smalben/Moose-Track/README.md

# Moose-Track

This is a shooting helpy thing
