smalben/Moose-Track/Documentation/motor_dimensions_zpsbda341d0.jpg

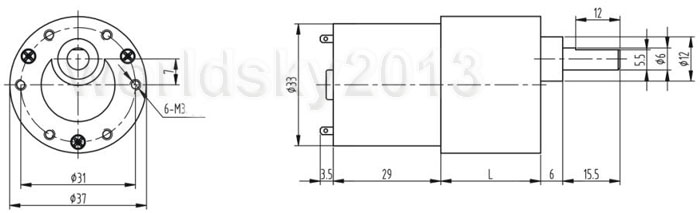
Documentation/motor_dimensions_zpsbda341d0.jpg
