smalben/Moose-Track/Documentation/proximity sensor sn04.jpg

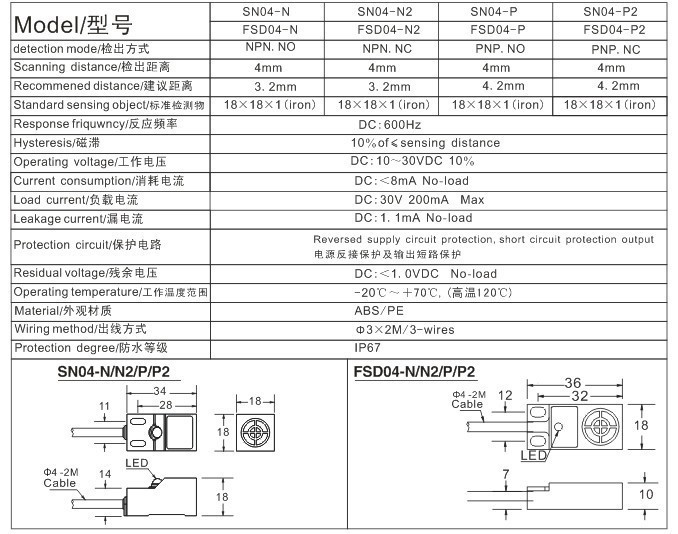
Documentation/proximity sensor sn04.jpg
