smalben/Moose-Track/CAD/drivhjul40.SLDPRT

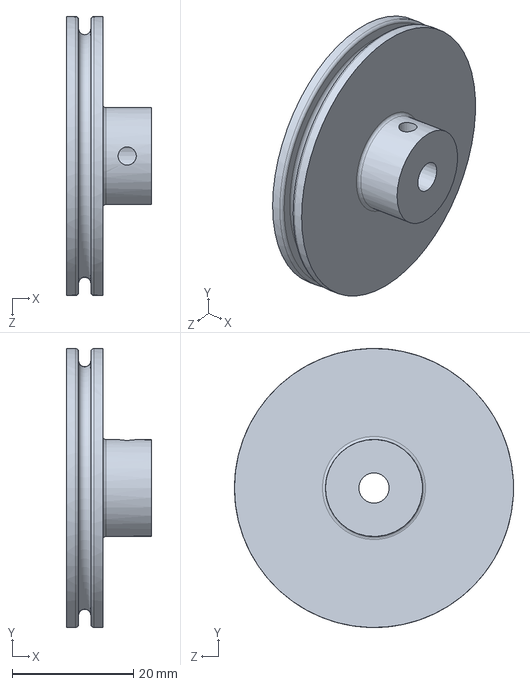
[picture p3: CAD file, 2018-02-24]
CAD/drivhjul40.SLDPRT
14.0 x 46.0 x 46.0 mm
