smalben/Moose-Track/CAD/drivhjul30_3.STL

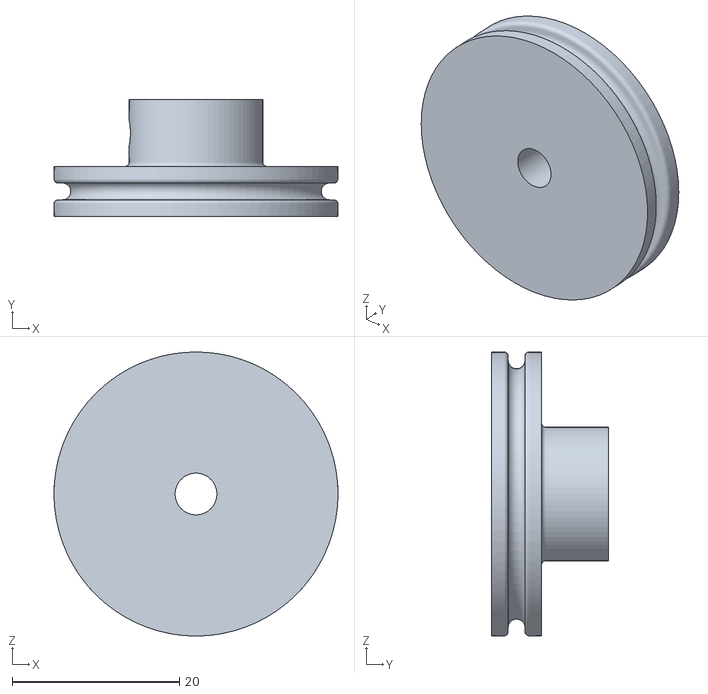
[picture p4: CAD file, 2018-02-24]
CAD/drivhjul30_3.STL
34.0 x 14.0 x 34.0
