smalben/Moose-Track/CAD/drivhjul40_3.STL

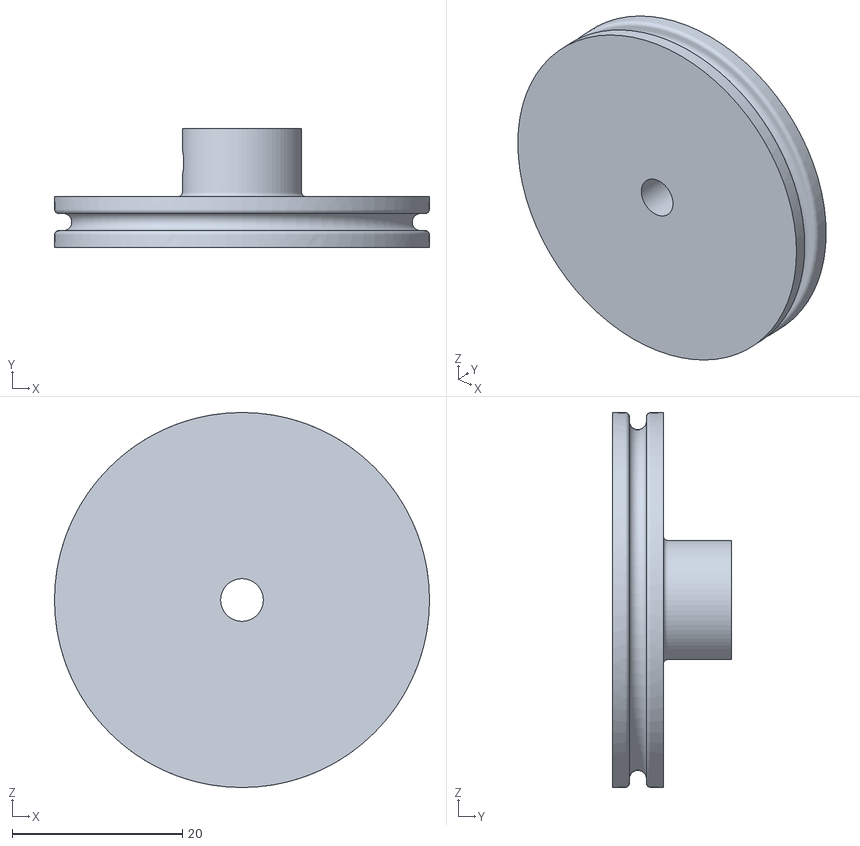
[picture p5: CAD file, 2018-02-24]
CAD/drivhjul40_3.STL
44.0 x 14.0 x 44.0
