smalben/Moose-Track/CAD/drivhjul30.SLDPRT

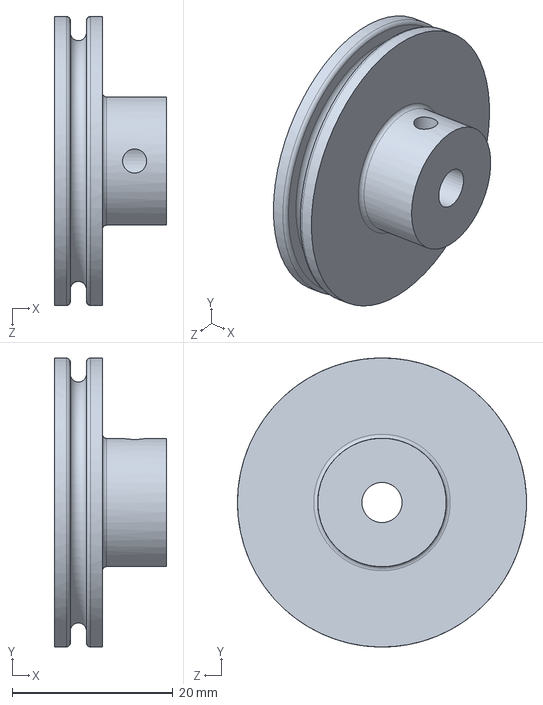
[picture p6: CAD file, 2018-02-24]
CAD/drivhjul30.SLDPRT
14.0 x 36.0 x 36.0 mm
