smalben/Moose-Track/(list of files, cad)

Other CAD files:
CAD/drivhjul40_2.STL
CAD/drivhjul30_2.STL
CAD/Drivhjul.dwg
