smalben/Moose-Track/Documentation/öra.pdf

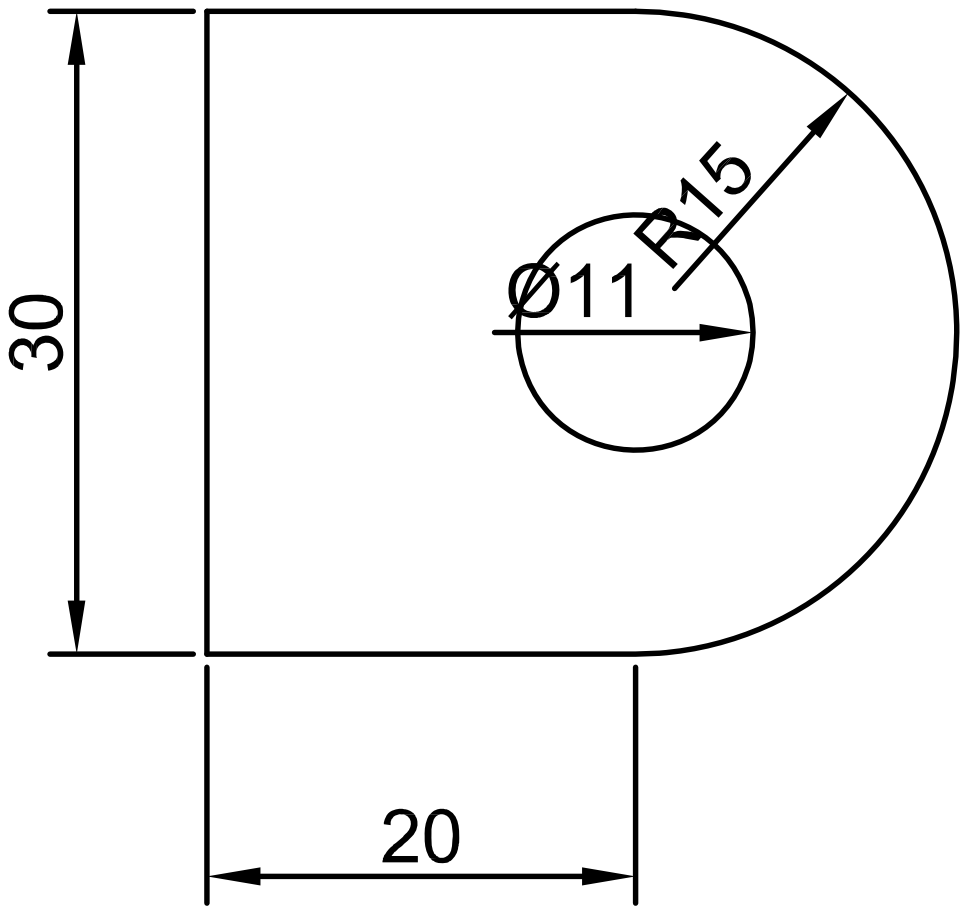
[picture p7: page 1]
