smalben/Moose-Track/PCB/moderkort.brd

## EAGLE design PCB/moderkort.brd (2018-02-24)

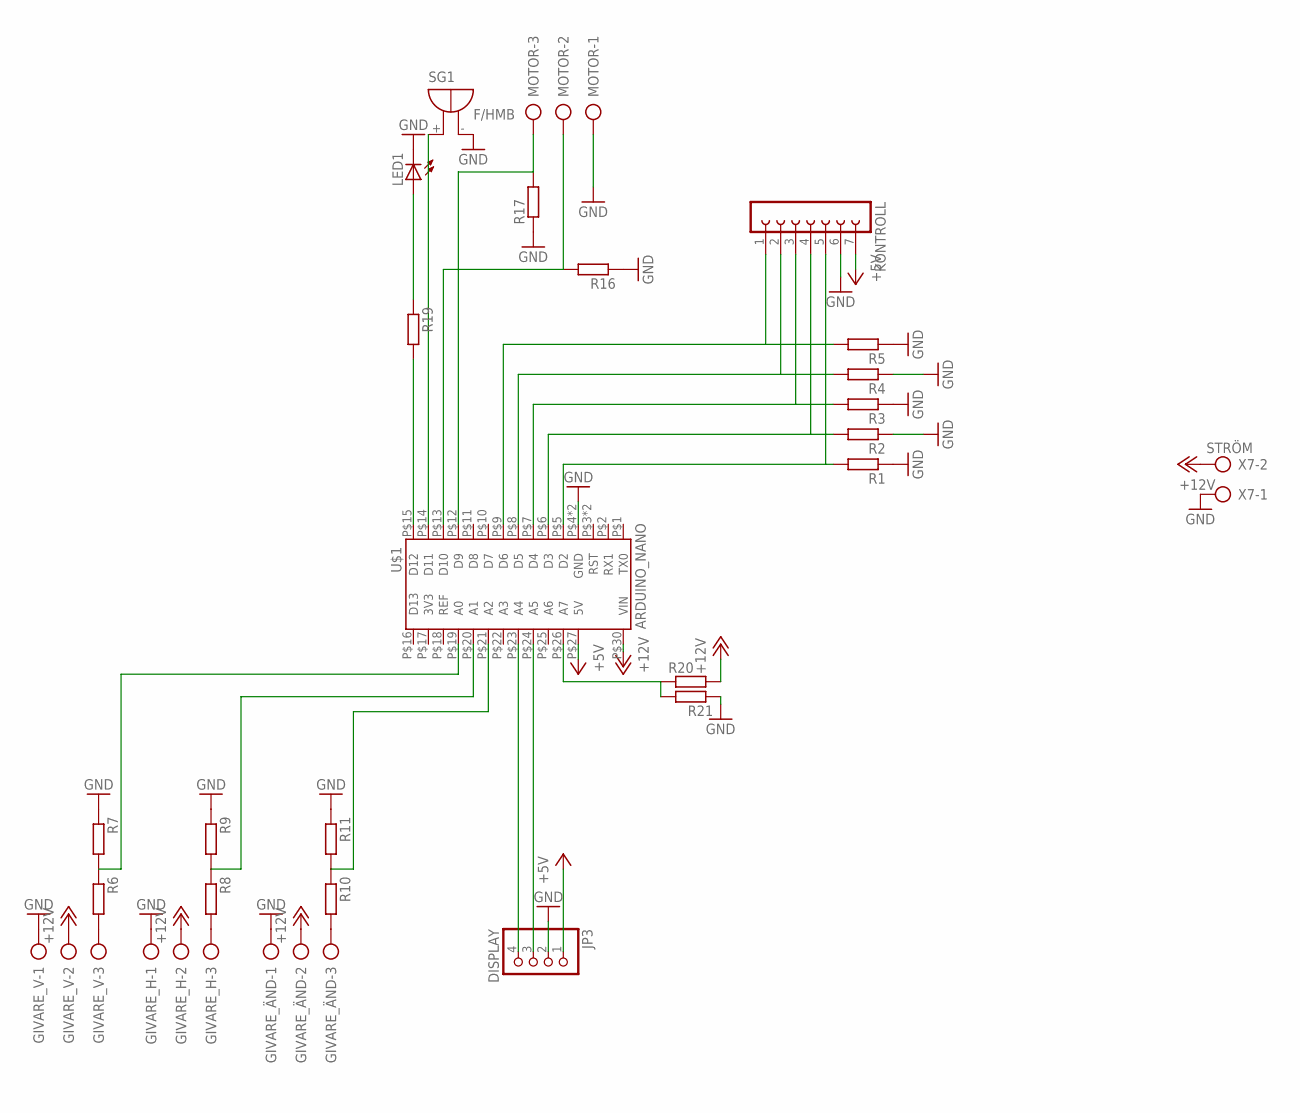
[picture p8: schematic moderkort.sch]

Parts:
GIVARE_H: AK500/3
GIVARE_V: AK500/3
GIVARE_ÄND: AK500/3
JP3: DISPLAY; 1X04
KONTROLL: FE07-1; FE07
LED1: LED5MM
MOTOR: AK500/3
R1, R2, R3, R4, R5, R6, R7, R8, R9, R10, R11, R16, R17, R19, R20, R21: R-EU_M1206; M1206
SG1: F/HMB
U$1: ARDUINO_NANO
X7: STRÖM; AK500/2

Connections:
+5V: JP3.1, KONTROLL.7, U$1.P$27 (5V)
+12V: GIVARE_H.2, GIVARE_V.2, GIVARE_ÄND.2, R20.2, U$1.P$30 (VIN), X7.2
GND: GIVARE_H.1, GIVARE_V.1, GIVARE_ÄND.1, JP3.2, KONTROLL.6, LED1.K (C), MOTOR.1, R1.1, R2.1, R3.1, R4.1, R5.1, R7.1, R9.1, R11.1, R16.1, R17.1, R21.1, SG1.-, U$1.P$4 (GND), U$1.P$29 (GND), X7.1
unnamed: LED1.A, R19.1
unnamed: GIVARE_V.3, R6.2
unnamed: R6.1, R7.2, U$1.P$19 (A0)
unnamed: GIVARE_H.3, R8.2
unnamed: R8.1, R9.2, U$1.P$20 (A1)
unnamed: GIVARE_ÄND.3, R10.2
unnamed: R10.1, R11.2, U$1.P$21 (A2)
unnamed: MOTOR.3, R17.2, U$1.P$12 (D9)
unnamed: JP3.3, U$1.P$24 (A5)
unnamed: JP3.4, U$1.P$23 (A4)
unnamed: R19.2, U$1.P$15 (D12)
unnamed: KONTROLL.5, R1.2, U$1.P$5 (D2)
unnamed: KONTROLL.4, R2.2, U$1.P$6 (D3)
unnamed: KONTROLL.3, R3.2, U$1.P$7 (D4)
unnamed: KONTROLL.2, R4.2, U$1.P$8 (D5)
unnamed: KONTROLL.1, R5.2, U$1.P$9 (D6)
unnamed: SG1.+, U$1.P$14 (D11)
unnamed: MOTOR.2, R16.2, U$1.P$13 (D10)
unnamed: R20.1, R21.2, U$1.P$26 (A7)

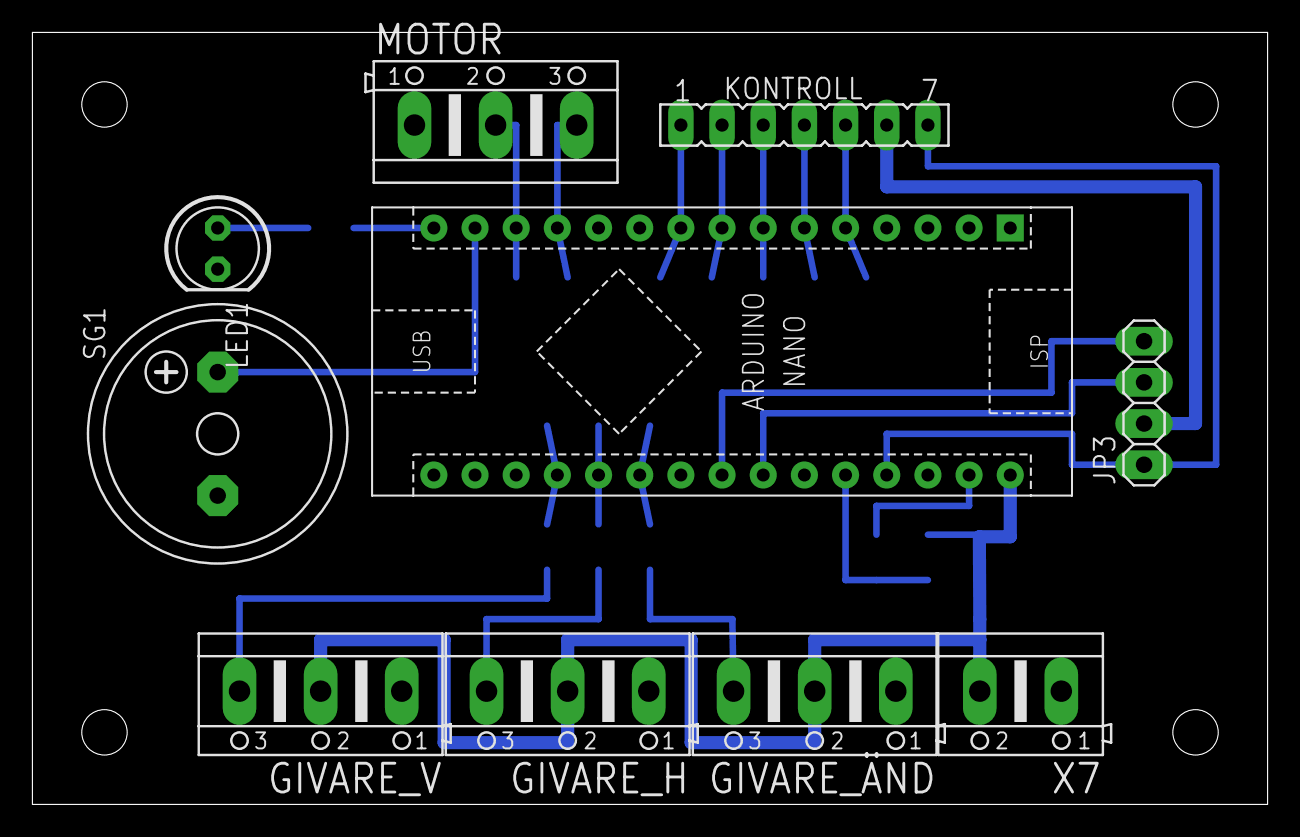
[picture p9: board moderkort.brd from above]

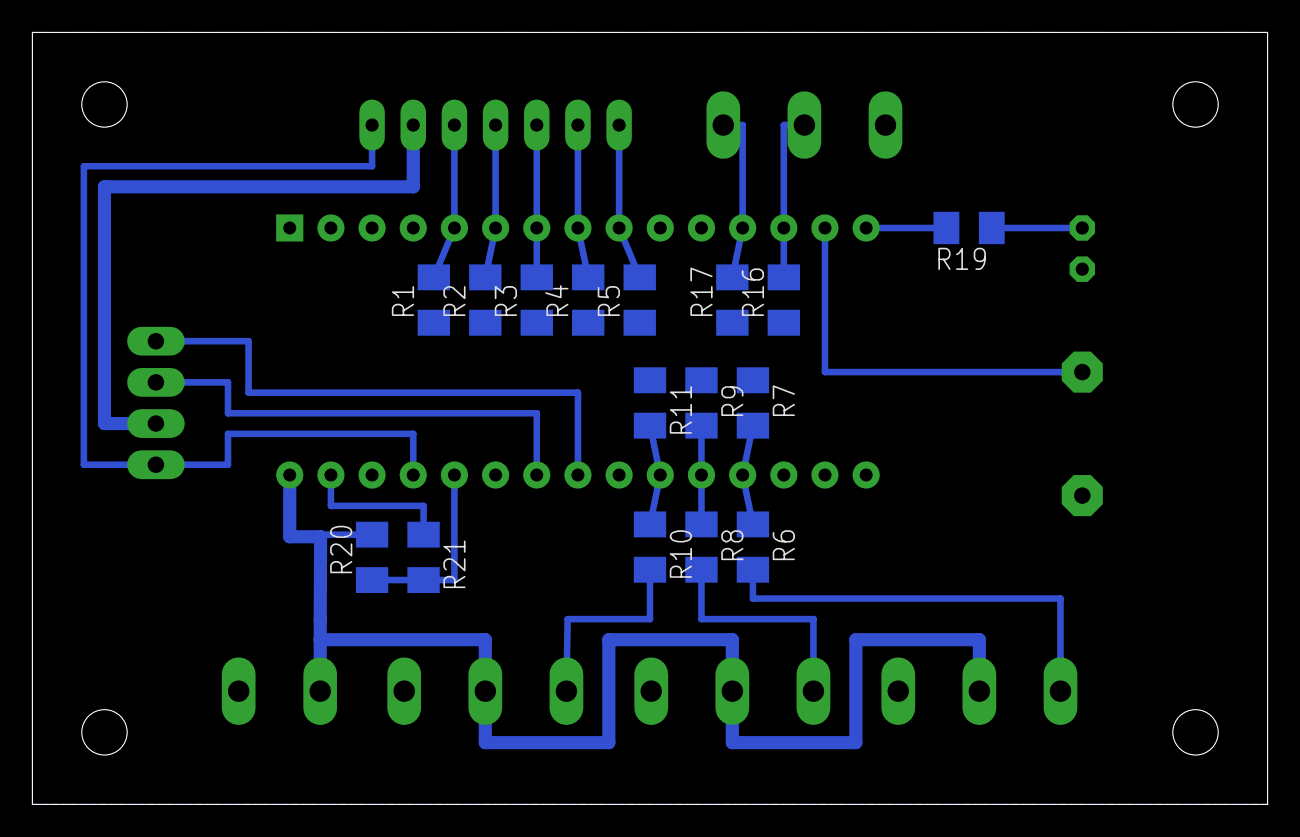
[picture p10: board moderkort.brd from below]

Board: 2 copper layers, 76.2 x 47.6 mm, 26 parts (16 on the bottom side), 22 nets.
