smalben/Moose-Track/mainProgram/beep.ino

void beep1(){
  digitalWrite(buzzerPin, HIGH);
  delay(400);
  digitalWrite(buzzerPin, LOW);
  delay(600);
  digitalWrite(buzzerPin, HIGH);
  delay(400);
  digitalWrite(buzzerPin, LOW);
  delay(600);
  digitalWrite(buzzerPin, HIGH);
  delay(1000);
  digitalWrite(buzzerPin, LOW);
}

void beep2(){
  digitalWrite(buzzerPin, HIGH);
  delay(150);
  digitalWrite(buzzerPin, LOW);
  delay(200);
  digitalWrite(buzzerPin, HIGH);
  delay(150);
  digitalWrite(buzzerPin, LOW);
  delay(200);
  digitalWrite(buzzerPin, HIGH);
  delay(150);
  digitalWrite(buzzerPin, LOW);
}
