smalben/Moose-Track/(commit log)

2018-02-24 Added project Arduino files
2018-02-24 Added documentation and CAD files
    [Drivhjul.dwg, drivhjul30.SLDPRT, drivhjul30_2.STL, drivhjul30_3.STL, drivhjul40.SLDPRT, drivhjul40_2.STL, drivhjul40_3.STL, moderkort.brd]
